chenyurong22/OpenDALI_EVG/Hardware/README.md

# Hardware

PCB designs for the OpenDALI_EVG project.

> Trademark notice — see [root README](../README.md): *DALI*, *DALI-2* etc. are DiiA trademarks; this project is an independent IEC 62386 implementation, not DiiA-certified.

## Manufacturing

The Gerber files are ready for upload to any PCB manufacturer. The JLCPCB files (BOM + CPL) allow direct ordering with SMT assembly through [JLCPCB](https://jlcpcb.com/).
