chenyurong22/OpenDALI_EVG/Hardware/DALI_Load_250W_RGBW/Readme.md

# LoadBoard 250W RGBW

LED driver and AC power switching board. Connects to the Controller via a 10-pin FFC cable (0.5 mm pitch) and provides:
- Mains switching for controlling the LED AC/DC Powersupply
- Power limits for the connected PSU: **max 1.2 A continuous** (without airflow), **max 3 A continuous** (with active airflow over the triac)
- 4-Channel PWM LED Driver (RGBW)

> **⚠ Work in progress.** This board is still under development.
> **⚠ Current Consumption** on the DALI Bus is to high while transfering from "off" to "on" state (4.1mA). This technically violates the specification.
