chenyurong22/OpenDALI_EVG/Hardware/DALI_Load_250W_RGBW/BOM-DALI_Load_250W_RGBW(V0.2).pdf

Comment | Description | Designator | Footprint | Quantity
MOC3043 | Zero-Cross Triac Driver Output Optocoupler | A1 | DIP762W46P254L889H5 08Q6B | 1
1uF | Capacitor | C1, C2, C3, C8 | C0402 | 4
100nF | Capacitor | C4, C5, C11 | C0402 | 3
10uF/50V | Capacitor | C12, C19 | C1206 | 2
100nF/50V | Capacitor | C16 | C0402 | 1
22uF | Capacitor | C17, C18 | C0603 | 2
ACST410-8BTR | TRIAC Alternistor -Snubberless, 600V, 4A DPAK | D1 | TO229P994X240-3N (DPAK) | 1
1N4148W | Diode | D2 | SOD-123 | 1
1.5A | Fuse | F1 | 1808 Fuse / FUSE_0154004 | 1
GZ1608D601TF | Ferrite_Bead | FB1 | 0603 | 1
LGS5145 | 60-V, 600-mA High Efficiency Wide Input Voltage Range Buck Converter | IC1 | SOT95P280X110-6N (SOT23-6L) | 1
FFC 0.5mm 10Pin 90° | FFC 0.5mm 10P Bottom Connection C262659 | J1 | TE_1-1734592-0 | 1
NLCV32T-100K-PF (10uH) | 15uH | L1 | L1210 | 1
KF142R-5.08-4P | KF142R-5.08-4P | P1 | CONN-TH_4P-P5.08_KF142R-5.08-4P | 1
KF2EDGR-3.81-5Pin | KF2EDGR-3.81-5Pin | P2 | CONN-TH_5P-P3.81_KF2EDGR-3.81-5P | 1
4 Pin male | 4 Pin male | P7 | TE_826647-4 | 1
AO3400A | 30V N-Channel MOSFET | Q1 | SOT23 Normal | 1
IRLU024N | N-HEXFET Power MOSFET | Q3, Q4, Q5, Q6 | TO228P680X240X837-3 (TO-251) | 4
10 | Resistor | R1, R2, R3, R7, R8, R9, R10, R17 | 0402 | 8
390 | Resistor | R4, R16 | R0603 | 2
100k | Resistor | R12, R13, R14, R15, R19 | 0402 | 5
1k | Resistor | R18 | 0402 | 1
15k | Resistor | R20 | 0402 | 1
75k | Resistor | R46 | R0603 | 1
12k | Resistor | R47 | 0402 | 1
UCC27517DBVR | 4-A/4-A single-channel gate driver with 5-V UVLO and 13-ns prop delay in SOT-23 package | U1, U2, U3, U4 | SOT23-5 | 4
pi160M30 | π160M30 | U5 | SOIC127P600X180-16N SOP-16 | 1
