chenyurong22/OpenDALI_EVG/Hardware/Controller/JLC_PCBA_BOM-DALI_EVG_Controller(V0.3).xlsx

Comment | Description | Designator | Footprint | Quantity | JLCPCB Part #
100nF | Capacitor | C1, C3, C4, C11, C13, C14, C15 | C0402 | 7 | C307331
1nF | Capacitor | C6 | C0603 | 1 | C1588
10uF/50V | Capacitor | C12, C19 | C1206 | 2 | C13585
100nF/50V | Capacitor | C16 | C0402 | 1 | C307331
22uF | Capacitor | C17, C18 | C0603 | 2 | C59461
1uF | Capacitor | C21 | C0603 | 1 | C15849
220uF/35V | Polarized Capacitor (Axial) | C24 | CAPR-5mm | 1 | C1590097
1N4148W | Diode | D1, D4 | SOD-123 | 2 | C81598
MB10S |  | D3 | SOIC245P670X290-4N | 1 | C2488
500mA | Fuse | F1, F2 | 1206 | 2 | C99561
GZ1608D601TF | Ferrite_Bead | FB1, FB2, FB3 | 0603 | 3 | C1002
LGS5145 | 60-V, 600-mA High Efficiency Wide Input Voltage Range Buck Converter | IC1 | SOT95P280X110-6N (SOT23-6L) | 1 | C5123971
C720477 | Tactile Switch | J2, J3 | TS-1088-AR02016 | 2 | C720477
FFC 0.5mm 10Pin 90° | FFC 0.5mm 10P Bottom Connection C262659 | J4 | TE_1-1734592-0 | 1 | C262659
Terminalblock X2 |  | J6, J7 | Terminalblock_X2_5mm | 2 | C474881
CMI321609X100KT (10uH) | 15uH | L1 | L1210 | 1 | C1051
KF2EDGR-3.5-2Pin | KF2EDGR-3.5-2Pin | P6 | CONN-TH_2P-P3.50_KF2EDGR-3.5 | 1 | C441171
Header | 4 Pin male | P7 | TE_826647-4 | 1
AO3400A | 30V N-Channel MOSFET | Q1 | SOT23 Normal | 1 | C20917
1 | Resistor | R2 | R0805 | 1 | C25271
1k | Resistor | R3, R29 | 0402 | 2 | C11702
100k | Resistor | R4 | 0402 | 1 | C25741
10k | Resistor | R8, R9, R18, R23, R47 | 0402 | 5 | C25744
15k | Resistor | R12 | 0402 | 1 | C25756
10 | Resistor | R27 | R0603 | 1 | C22859
470k | Resistor | R28 | R0603 | 1 | C23178
4.7k | Resistor | R30 | R0603 | 1 | C23162
100k | Resistor | R31 | R0603 | 1 | C25803
8.2k | Resistor | R32 | R0603 | 1 | C25981
18k | Resistor | R33 | R0603 | 1 | C25810
33k | Resistor | R46 | R0603 | 1 | C4216
CH32V003F4U6 | CPU Core:RISC-V CPU Maximum Speed:48MHz Program Storage Size:16KB Number of I/O:18 Applications:- | U1 | QFN-20_L3.0-W3.0-P0.40-TL-EP1.7 | 1 | C5299908
LMV331IDBVRG4 | Single General Purpose Low-Voltage Comparator 5-SOT-23 | U2 | SOT23-5 | 1 | C34731
AT24C256C-SSHL-T | AT24C256C-SSHL-T | U3 | SOIC127P600X265-8N (SOIC-8) | 1 | C6482
