chenyurong22/OpenDALI_EVG/Hardware/Controller/DALI_EVG_Controller_V0.3-Schematic.PDF

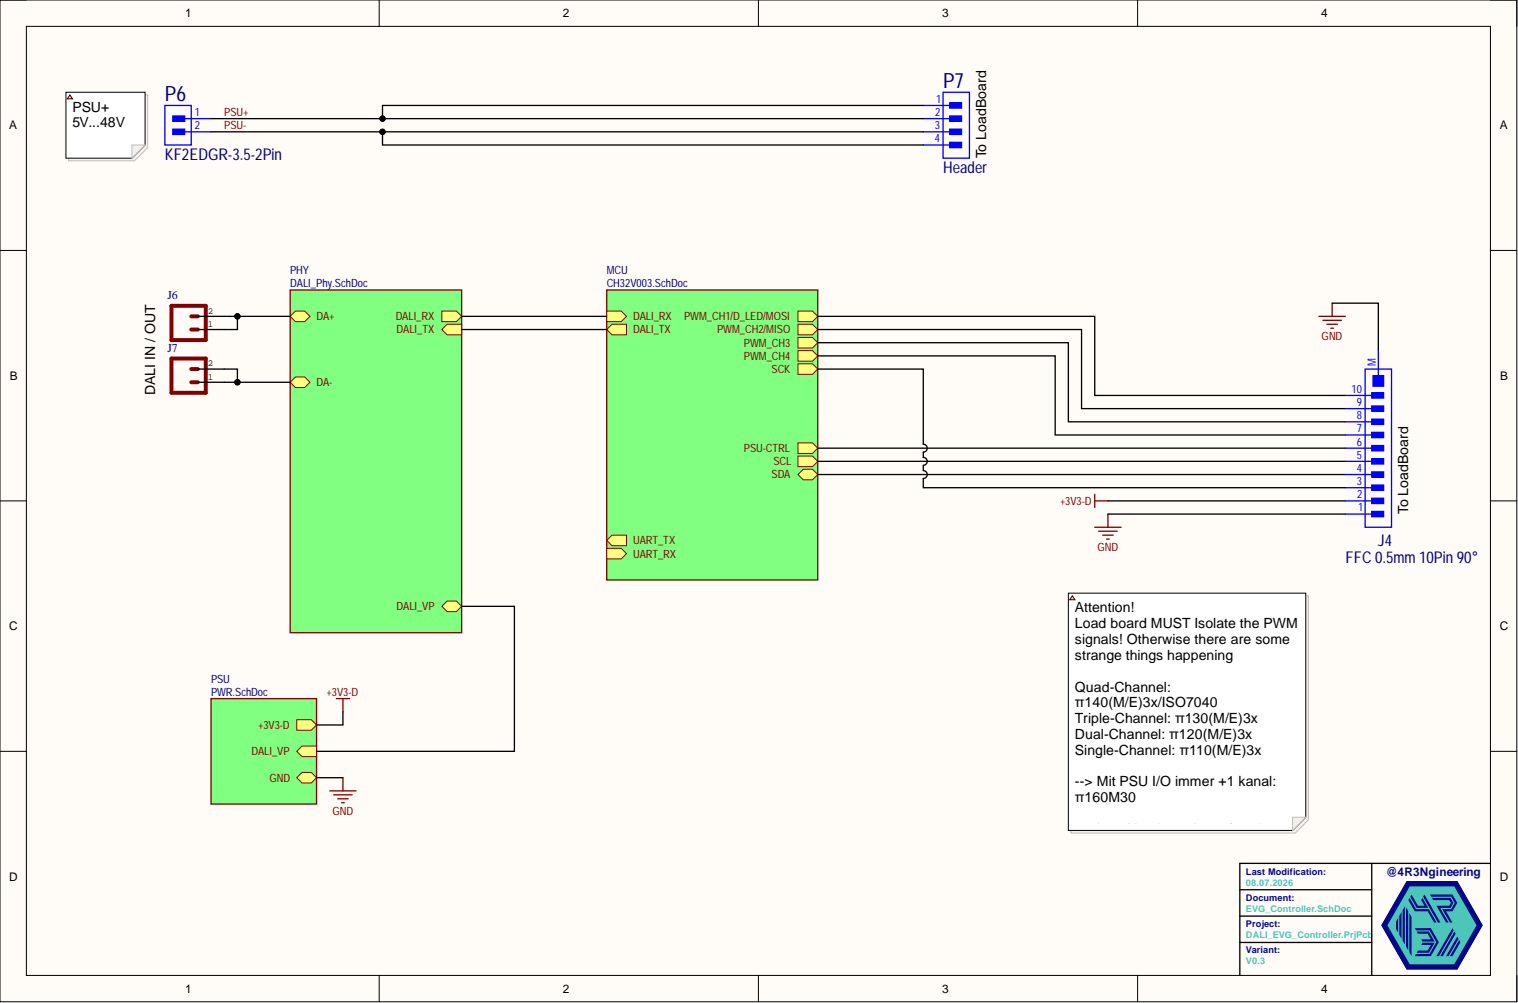
[picture p2: page 1]

Attention!
Load board MUS
signals! Otherwise there are some
strange things happening

Quad-Channel: π140(M/E)3x/ISO7040 Triple-Channel: π130(M/E

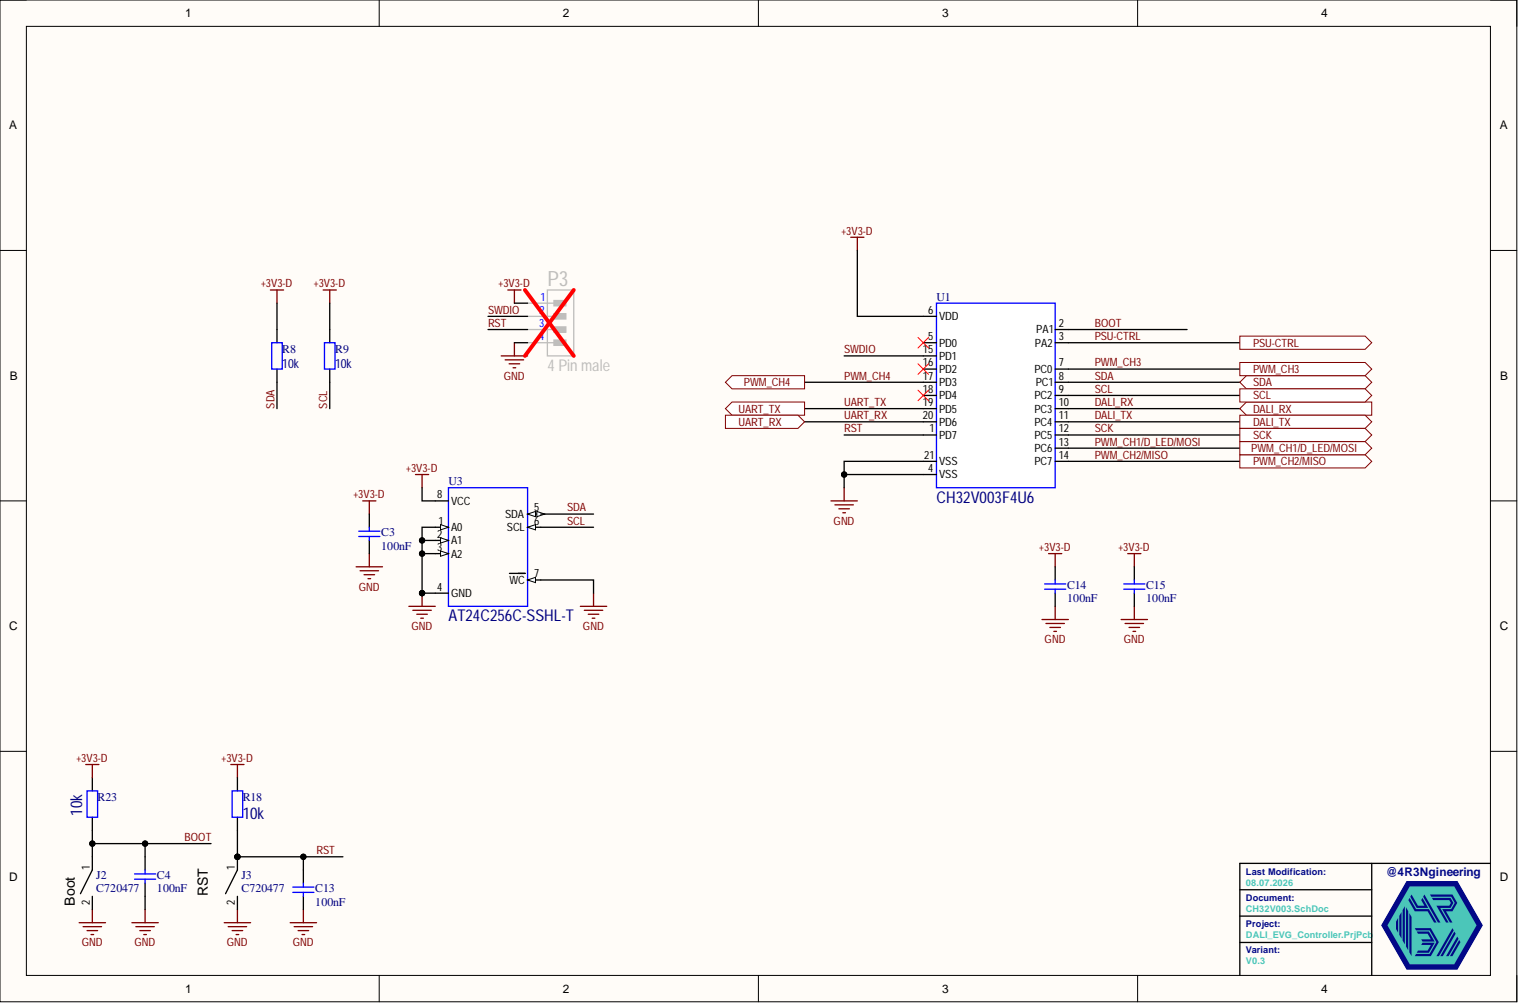
[picture p3: page 2]

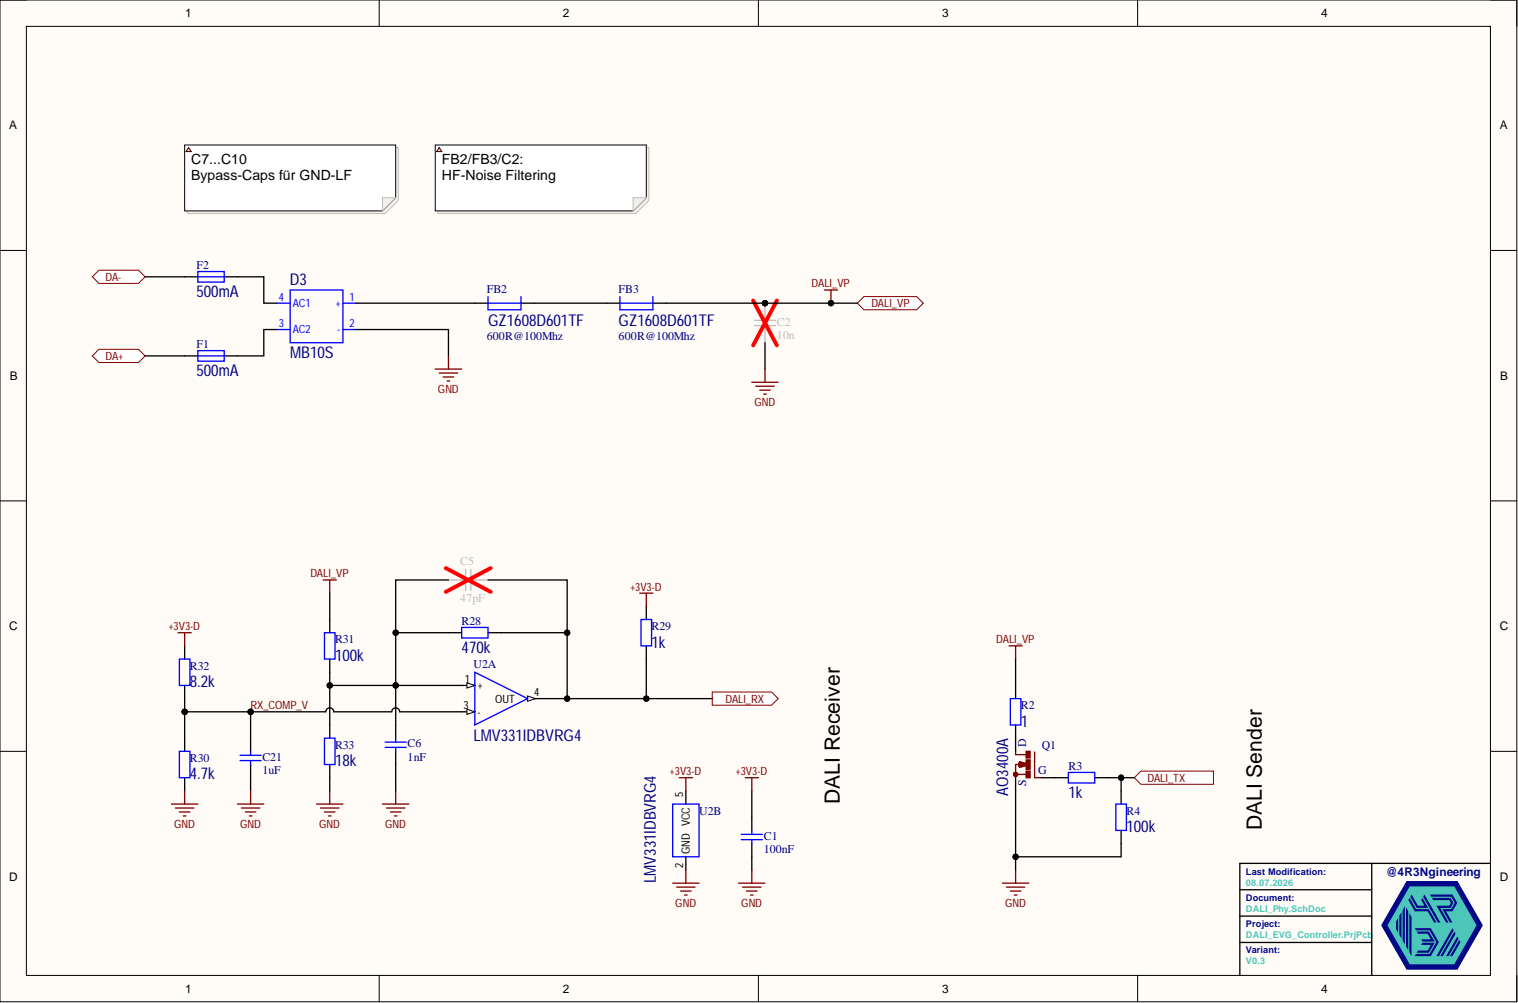
[picture p4: page 3]

Bypass-Caps für GND-LF

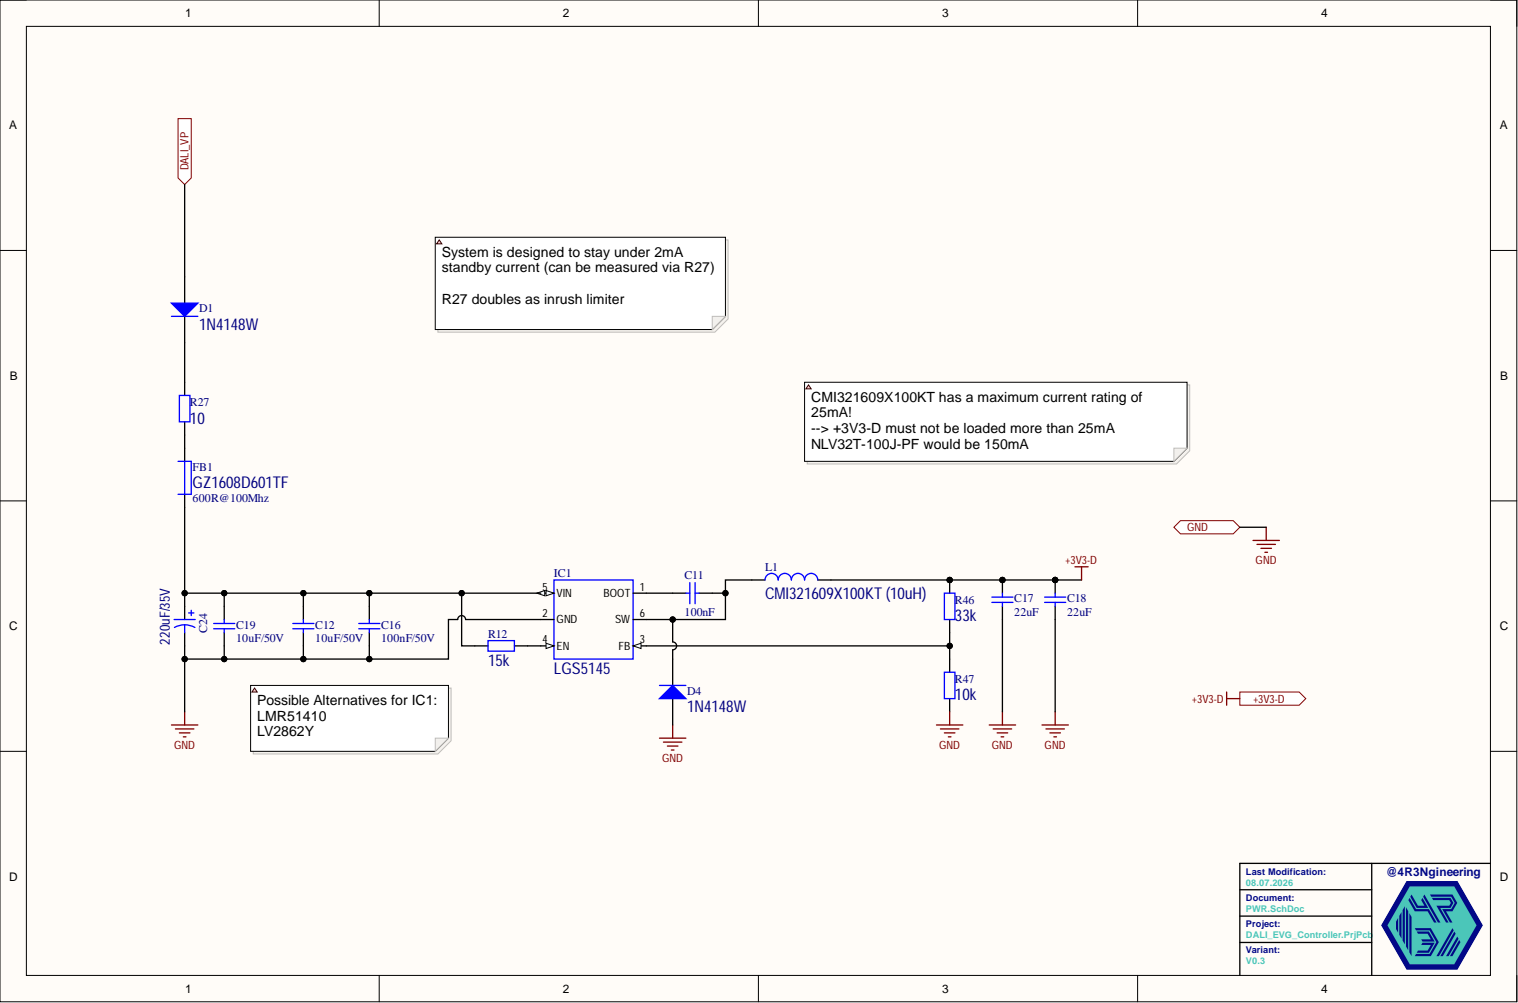
[picture p5: page 4]

System is designed to stay under 2m
standby cur

rent (can be measured via R27)

R27 doubles as inrush limiter

-> +3V3-D must not be loaded more than 25m
