chenyurong22/OpenDALI_EVG/Hardware/Controller/DALI_EVG_Controller_V0.3-Pinout.PDF

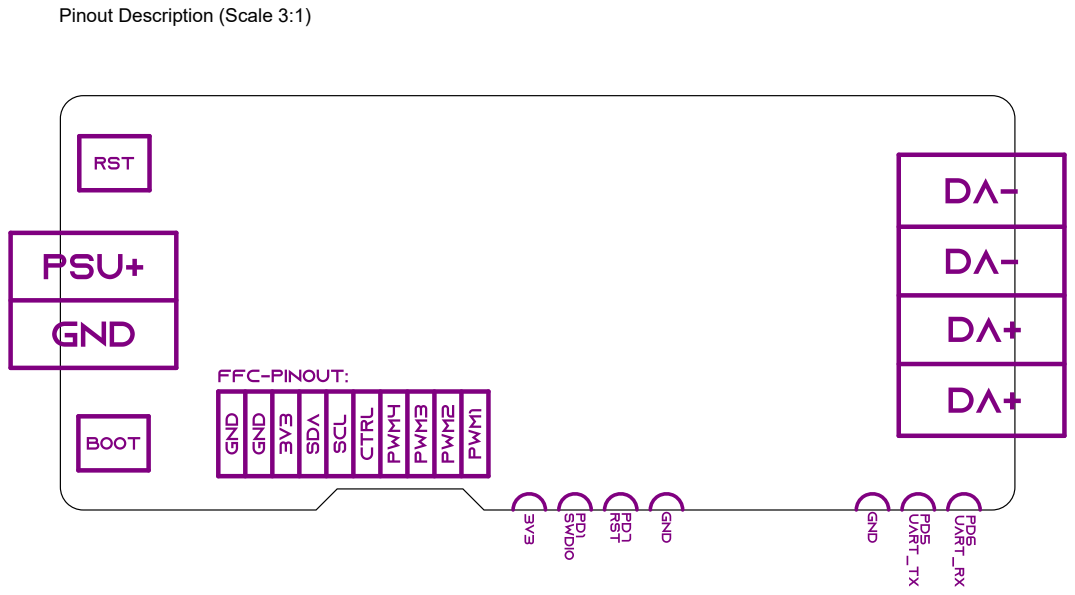
[picture p6: page 1]

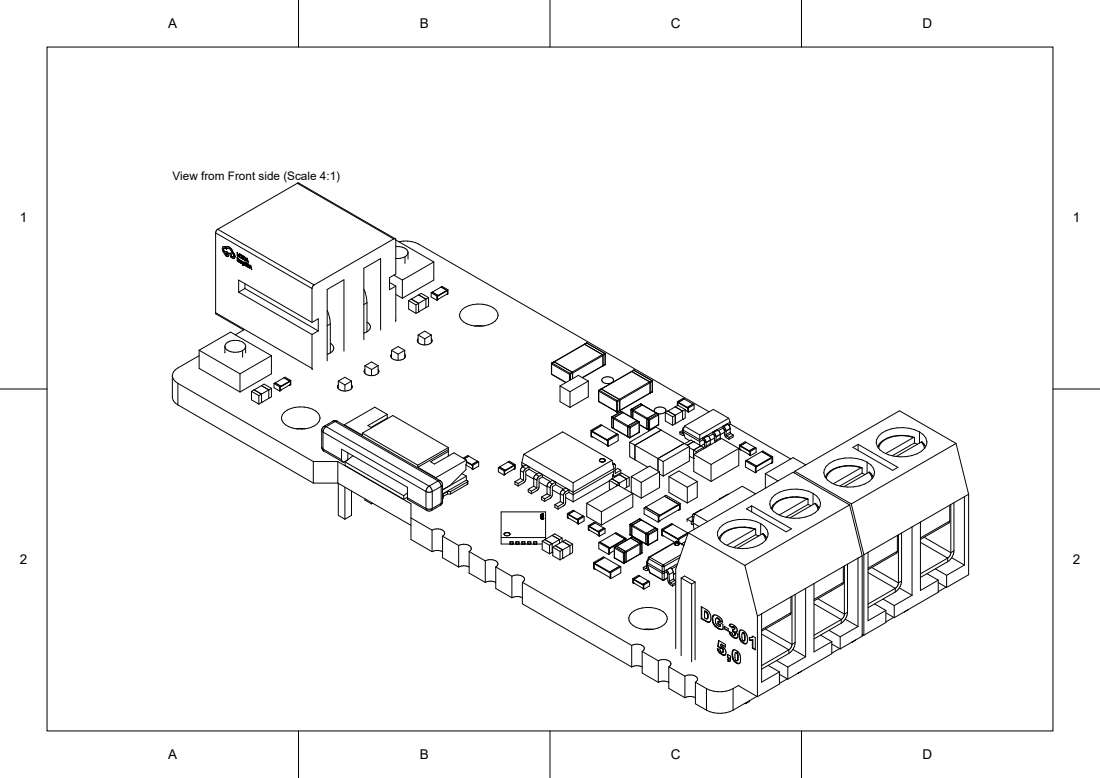
[picture p7: page 2]

View from Front side (Scale 4:1)
