chenyurong22/OpenDALI_EVG/Hardware/Controller/DALI_EVG_Controller_V0.3_Assembly.PDF

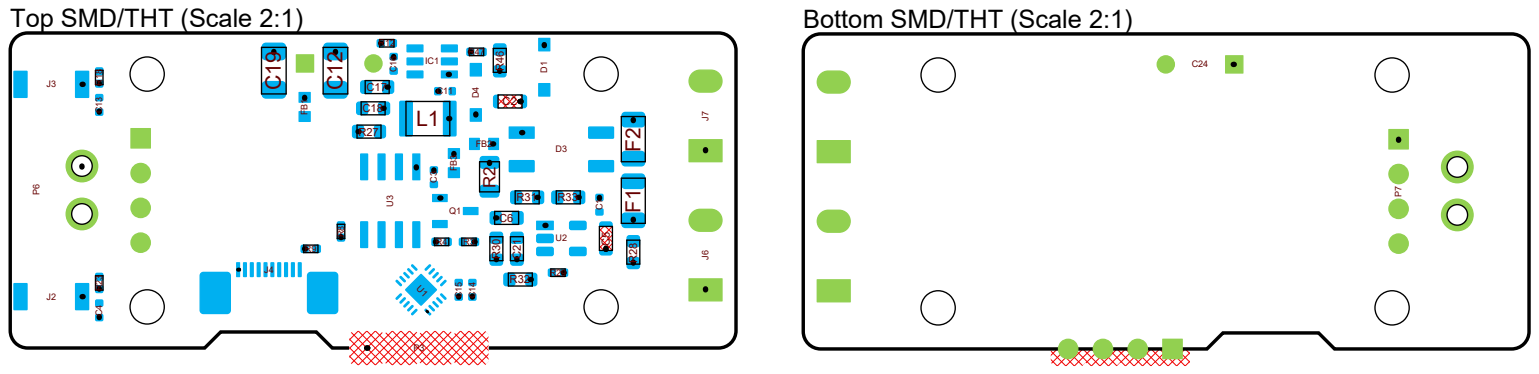
[picture p8: page 1]

Top SMD/THT (Scale 2:1)

Bottom SMD/THT (Scale 2:1)

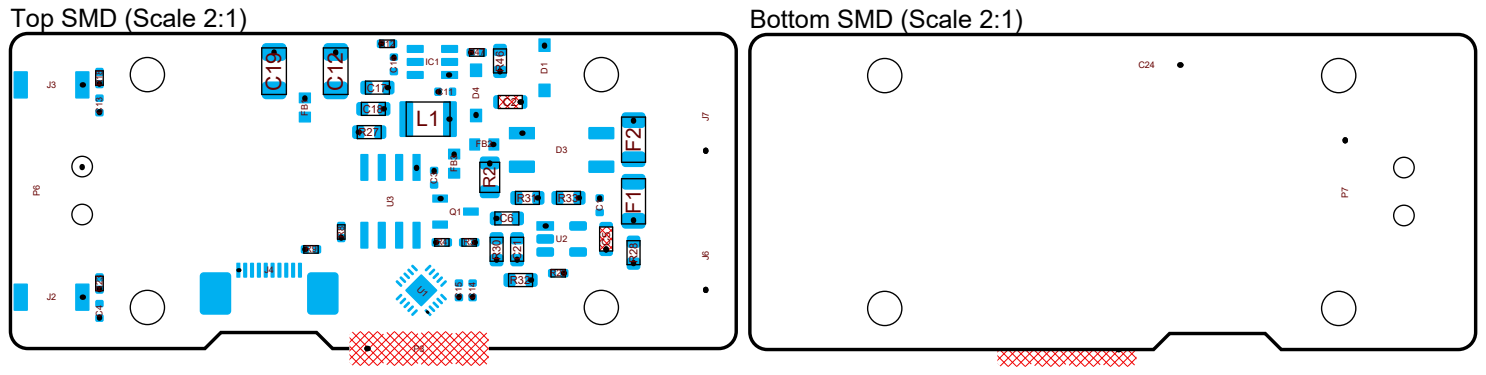
[picture p9: page 2]

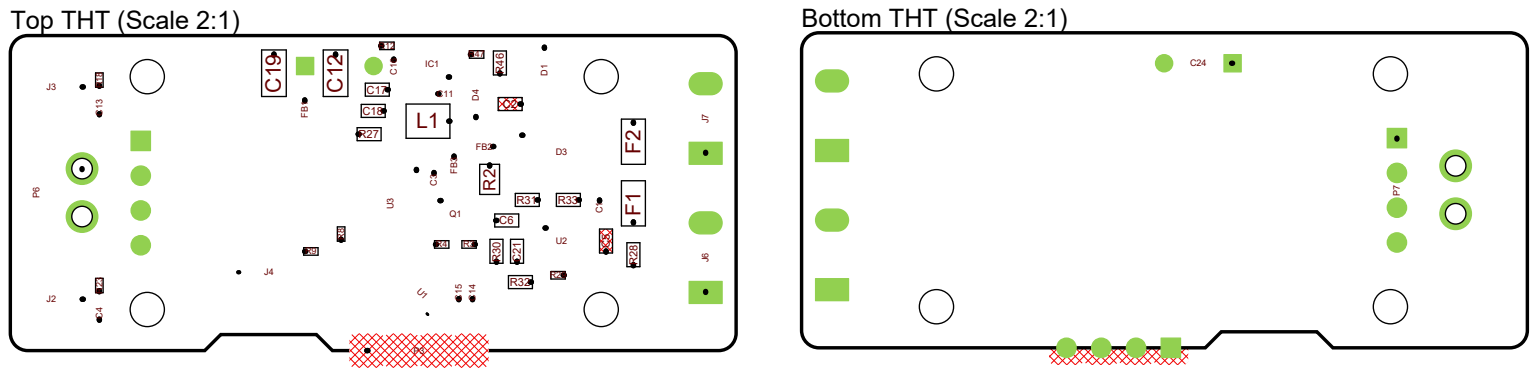
[picture p10: page 3]

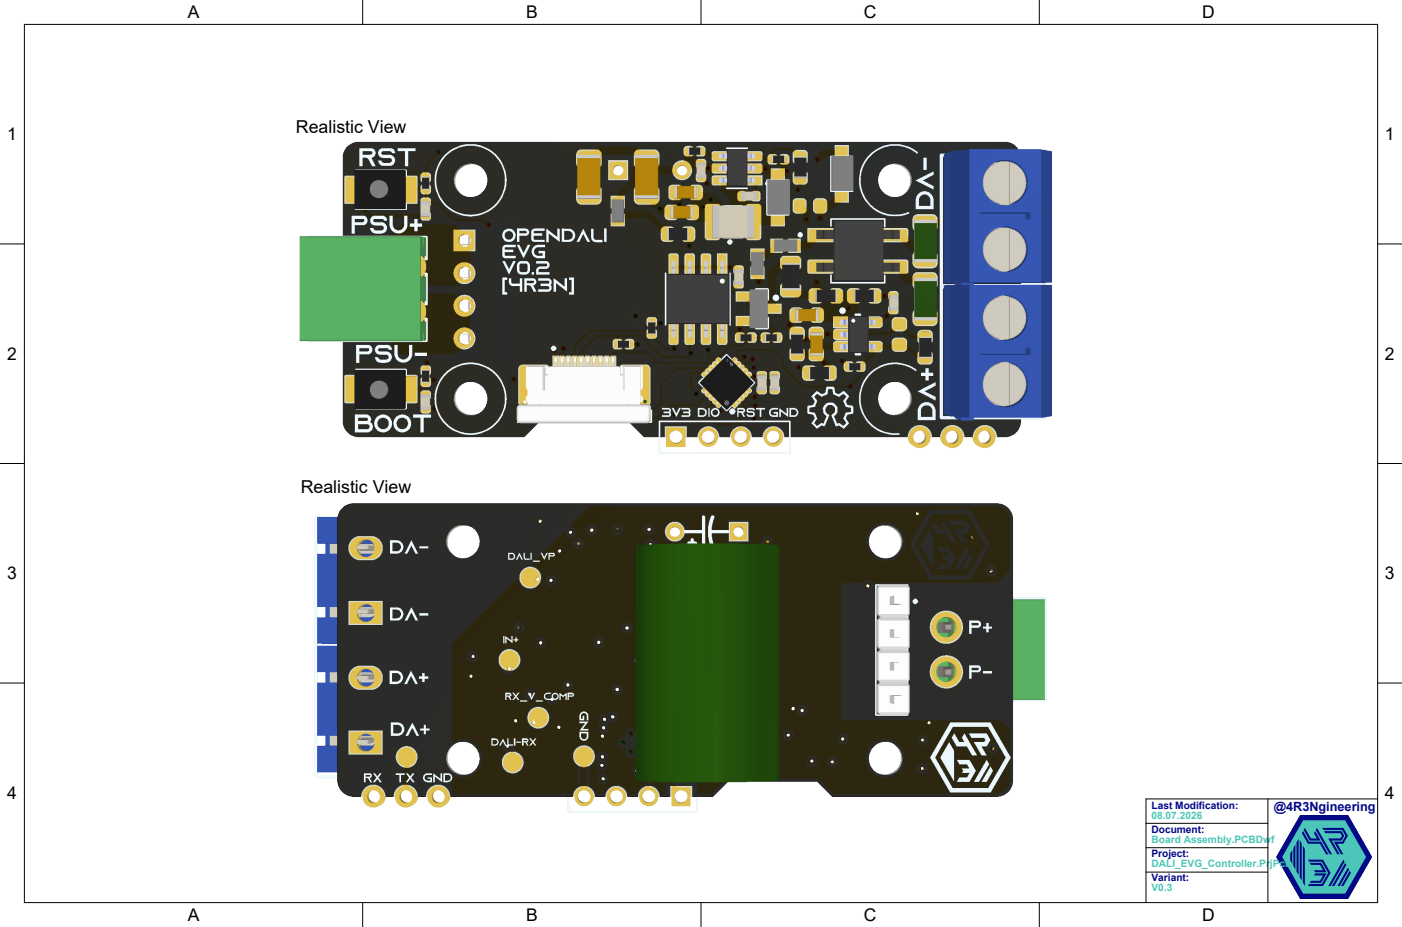
[picture p11: page 4]
