chenyurong22/OpenDALI_EVG/Hardware/DALI_Load_250W_RGBW/DALI_Load_250W_RGBW_V0.2_Assembly.PDF

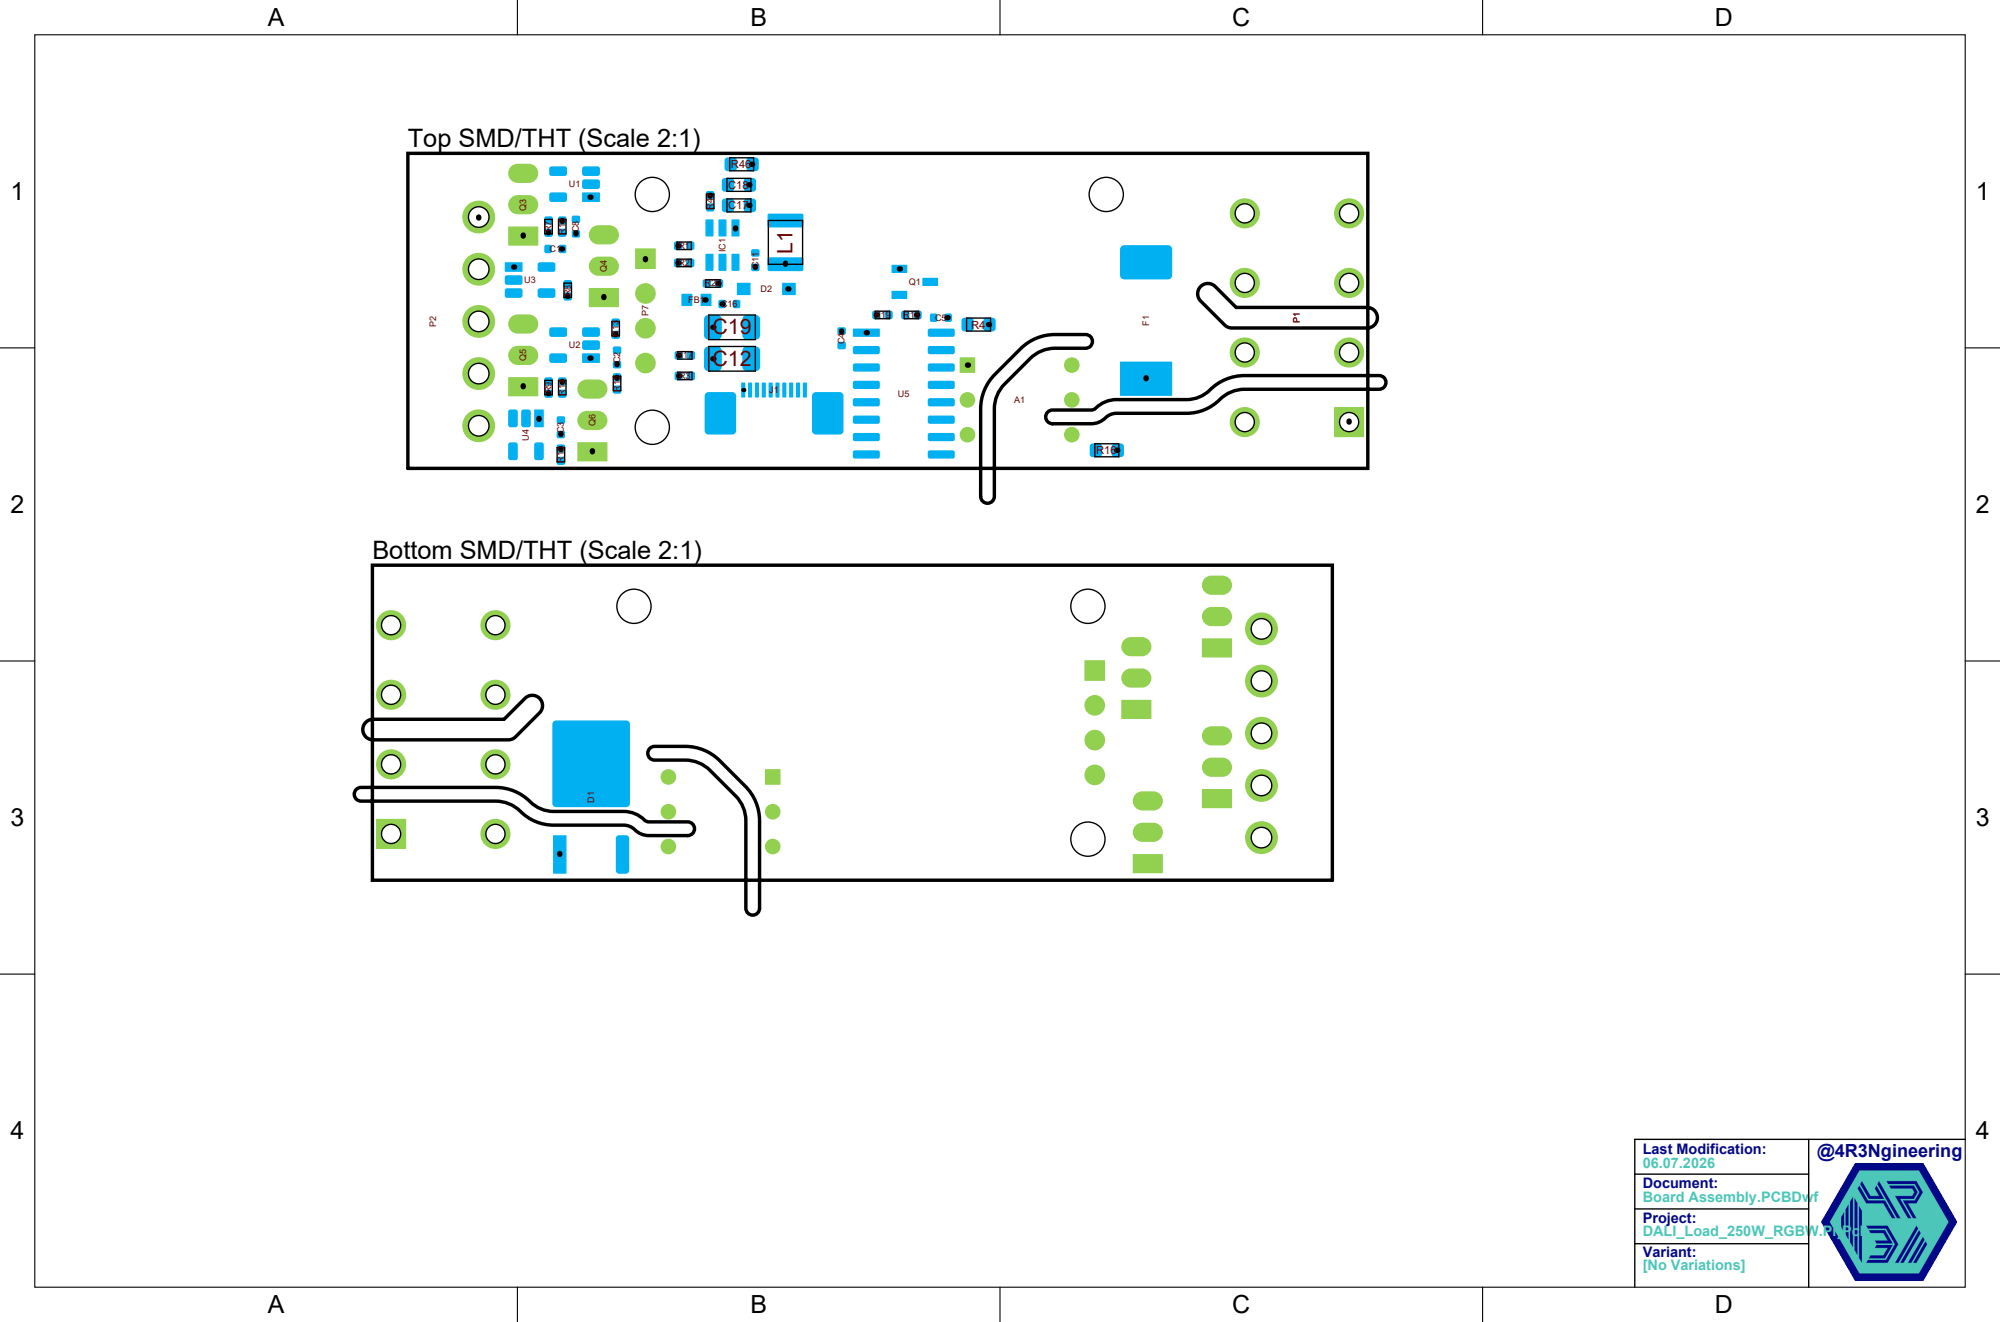
[picture p12: page 1]

Top SMD/THT (Scale 2:1) D1

Bottom SMD/THT (Scale 2:1)

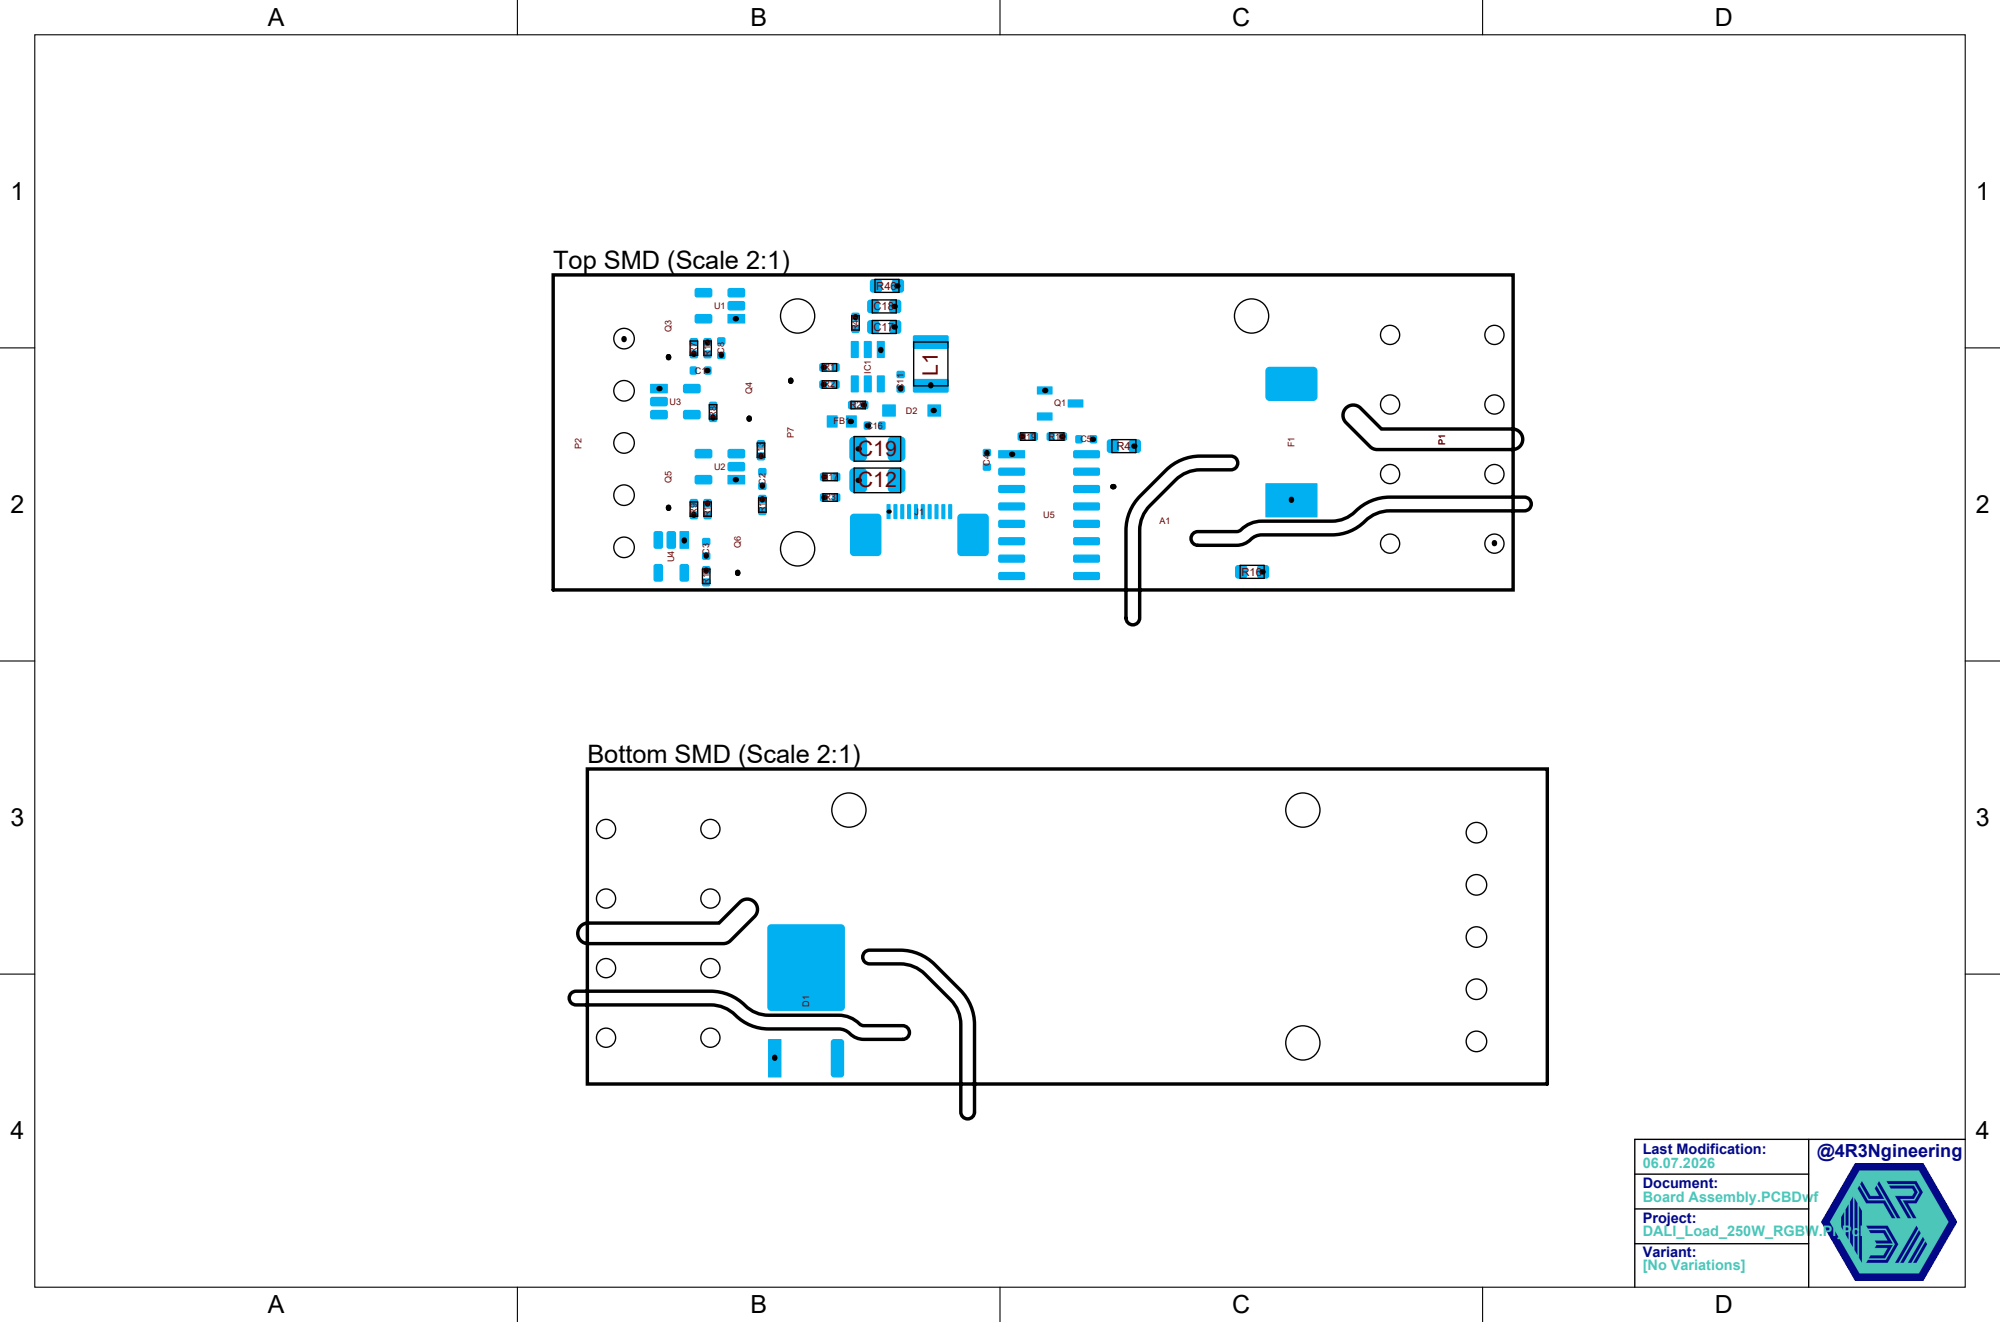
[picture p13: page 2]

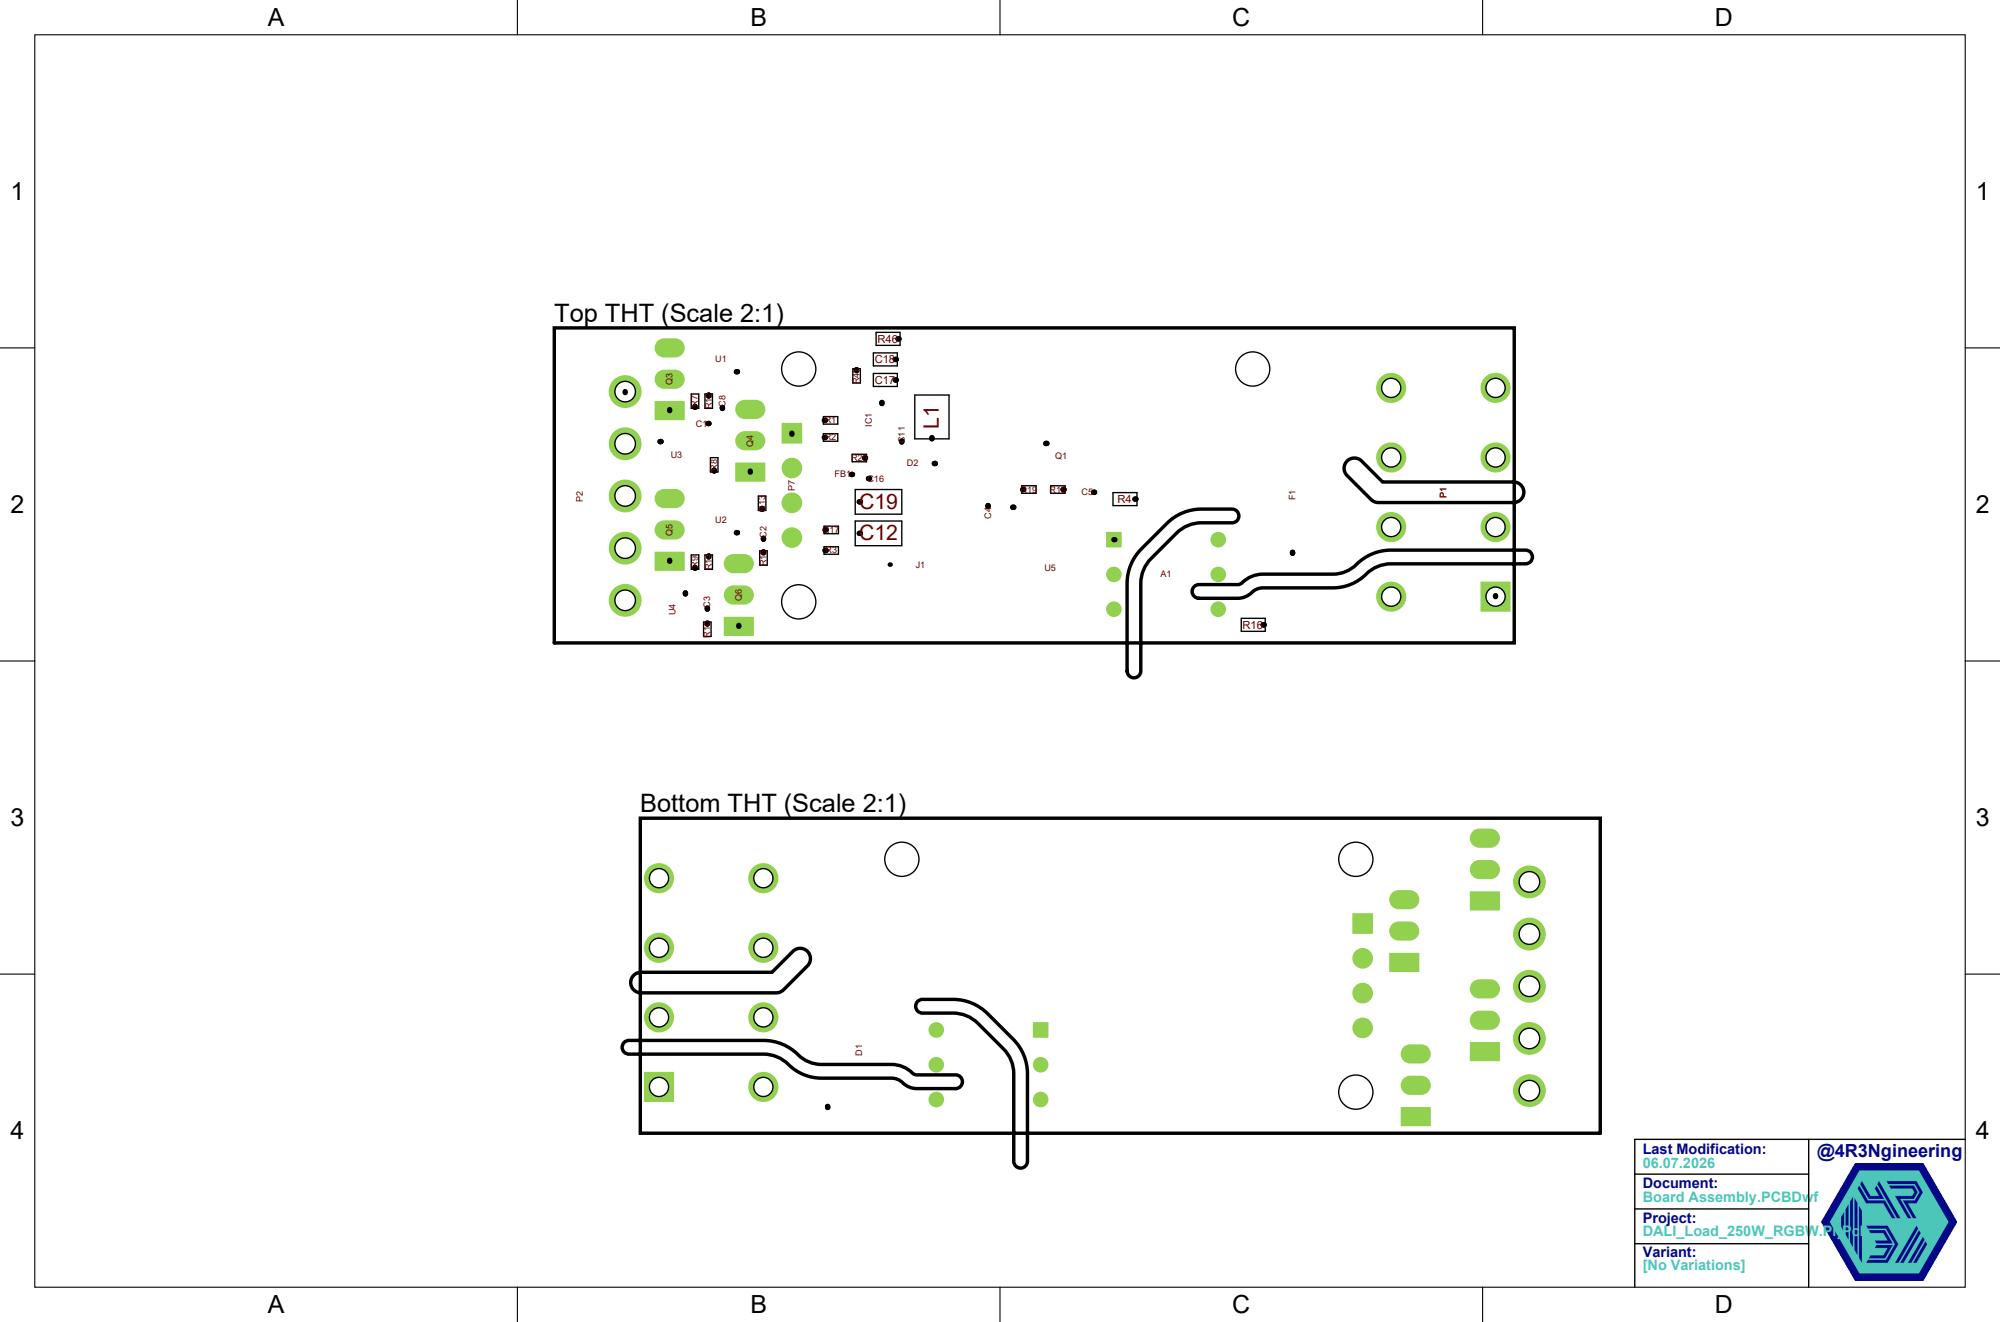
[picture p14: page 3]

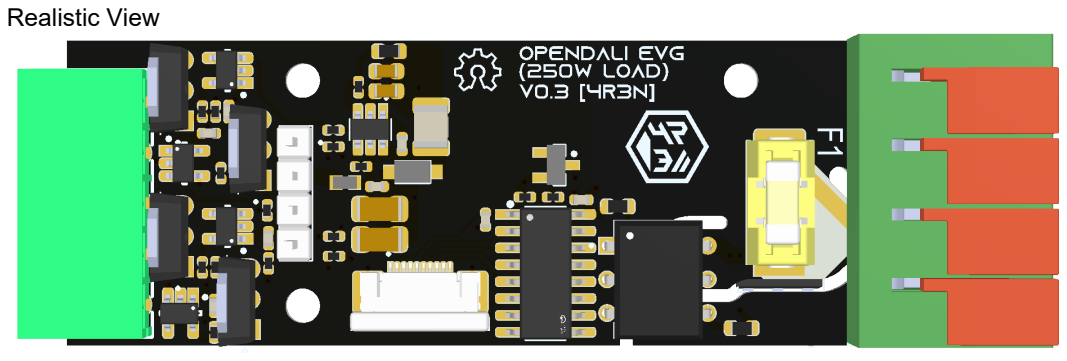
[picture p15: page 4]
