chenyurong22/OpenDALI_EVG/Hardware/DALI_Load_250W_RGBW/DALI_Load_250W_RGBW_V0.2-Schematic.PDF

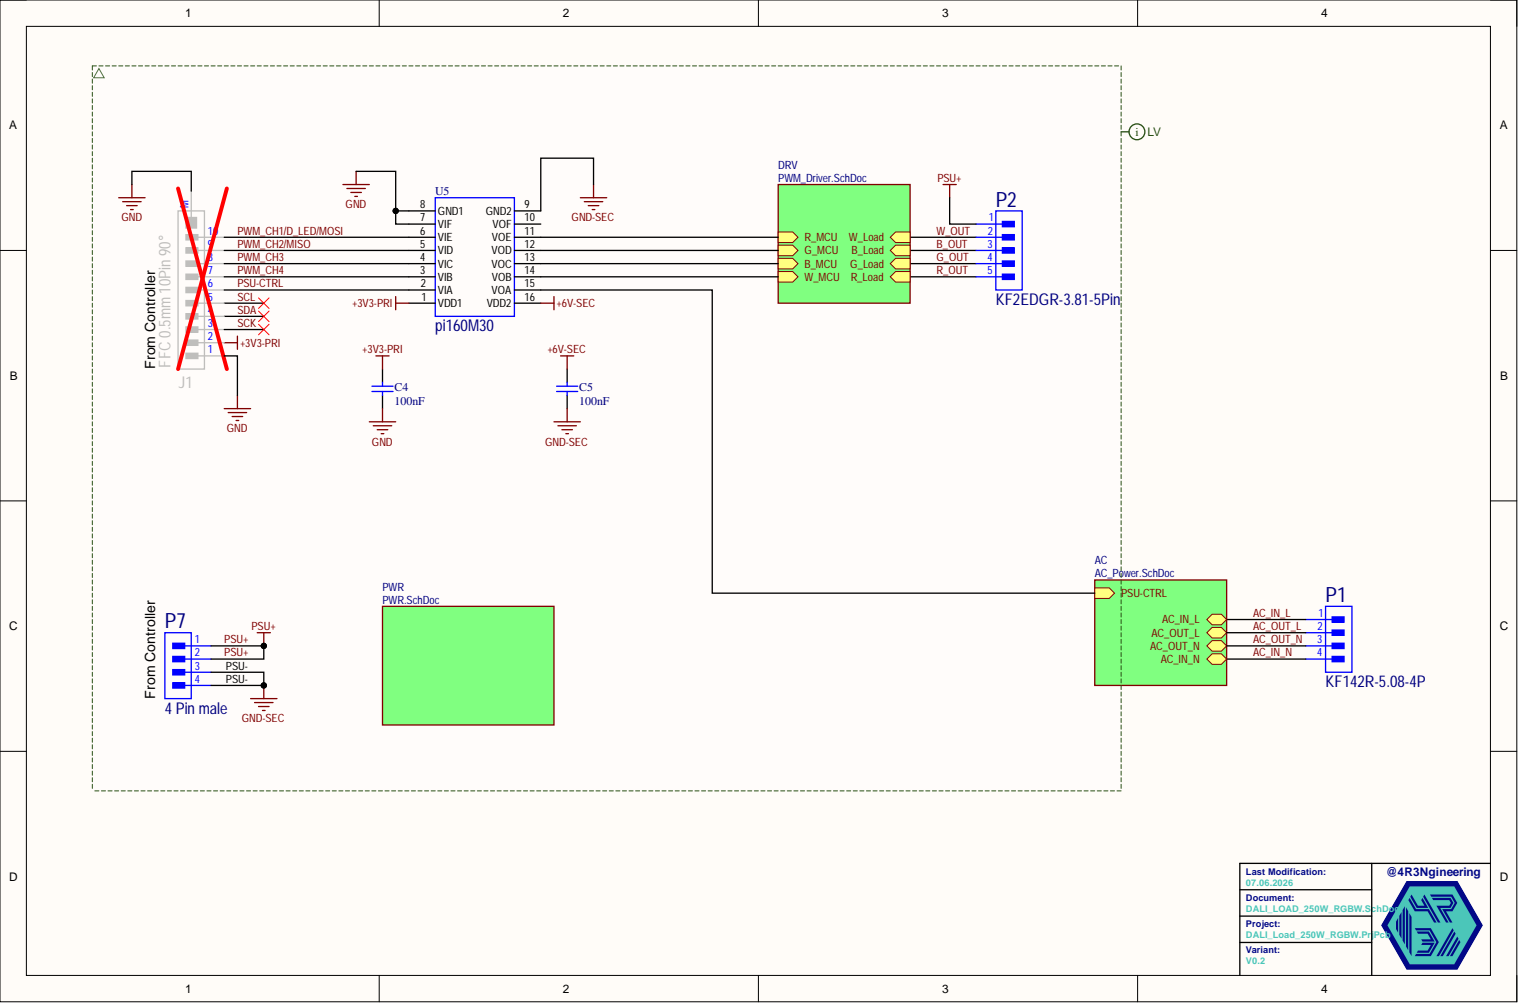
[picture p16: page 1]

From Controller

PSU-CTR L AC_IN_L AC_O UT_L AC_O UT_N AC_IN_N

PSU -

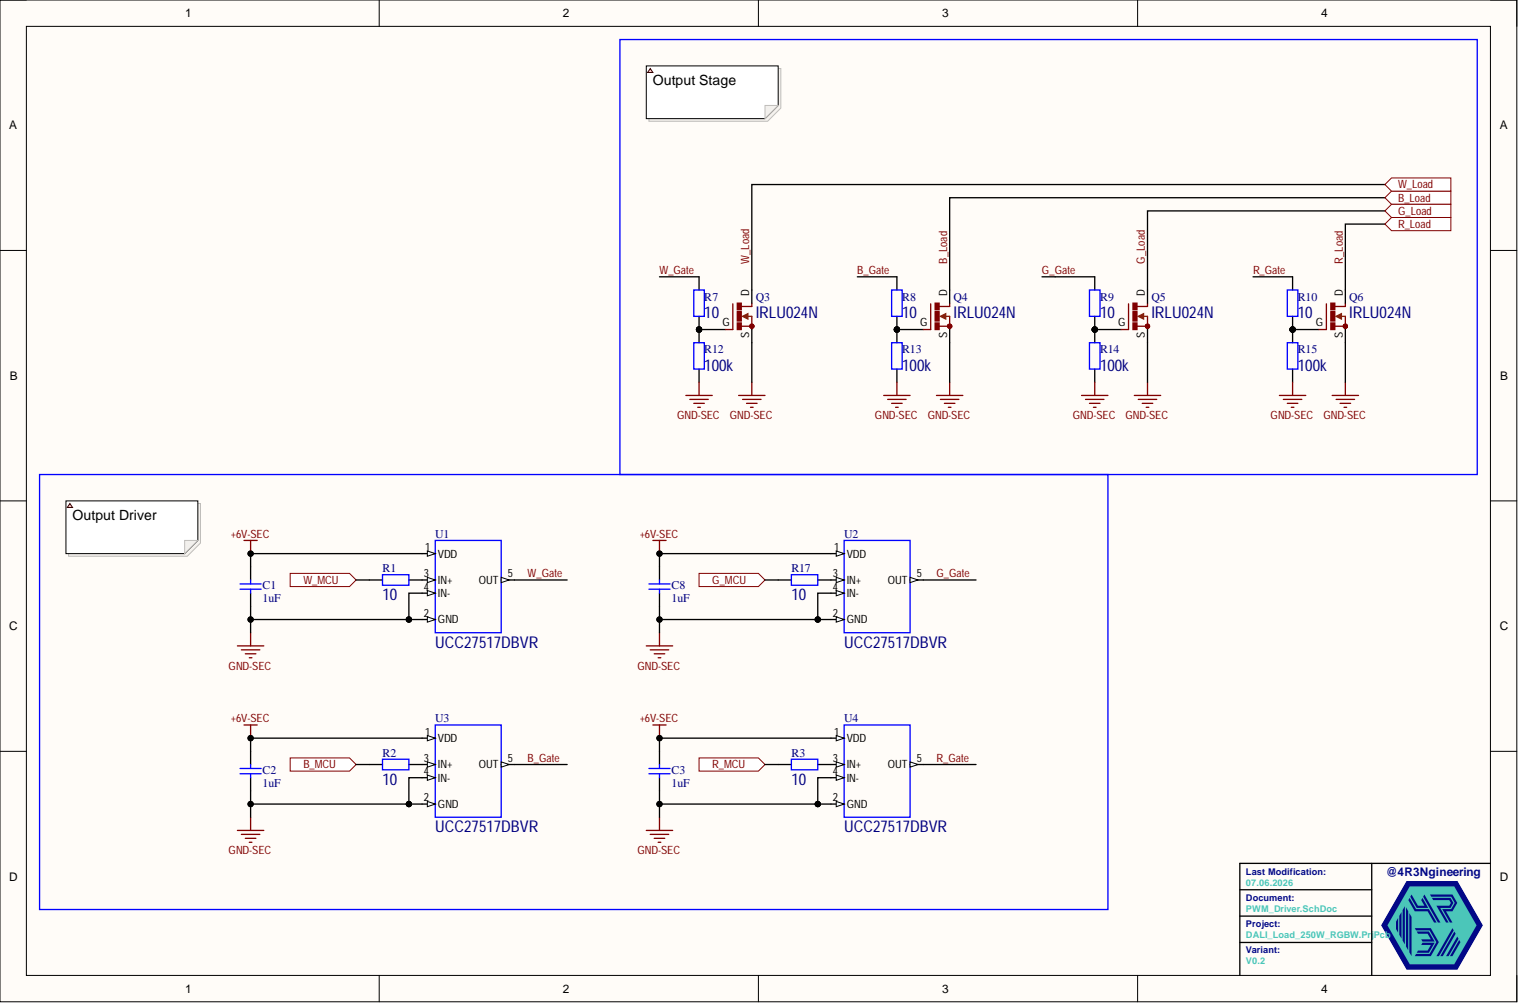
[picture p17: page 2]

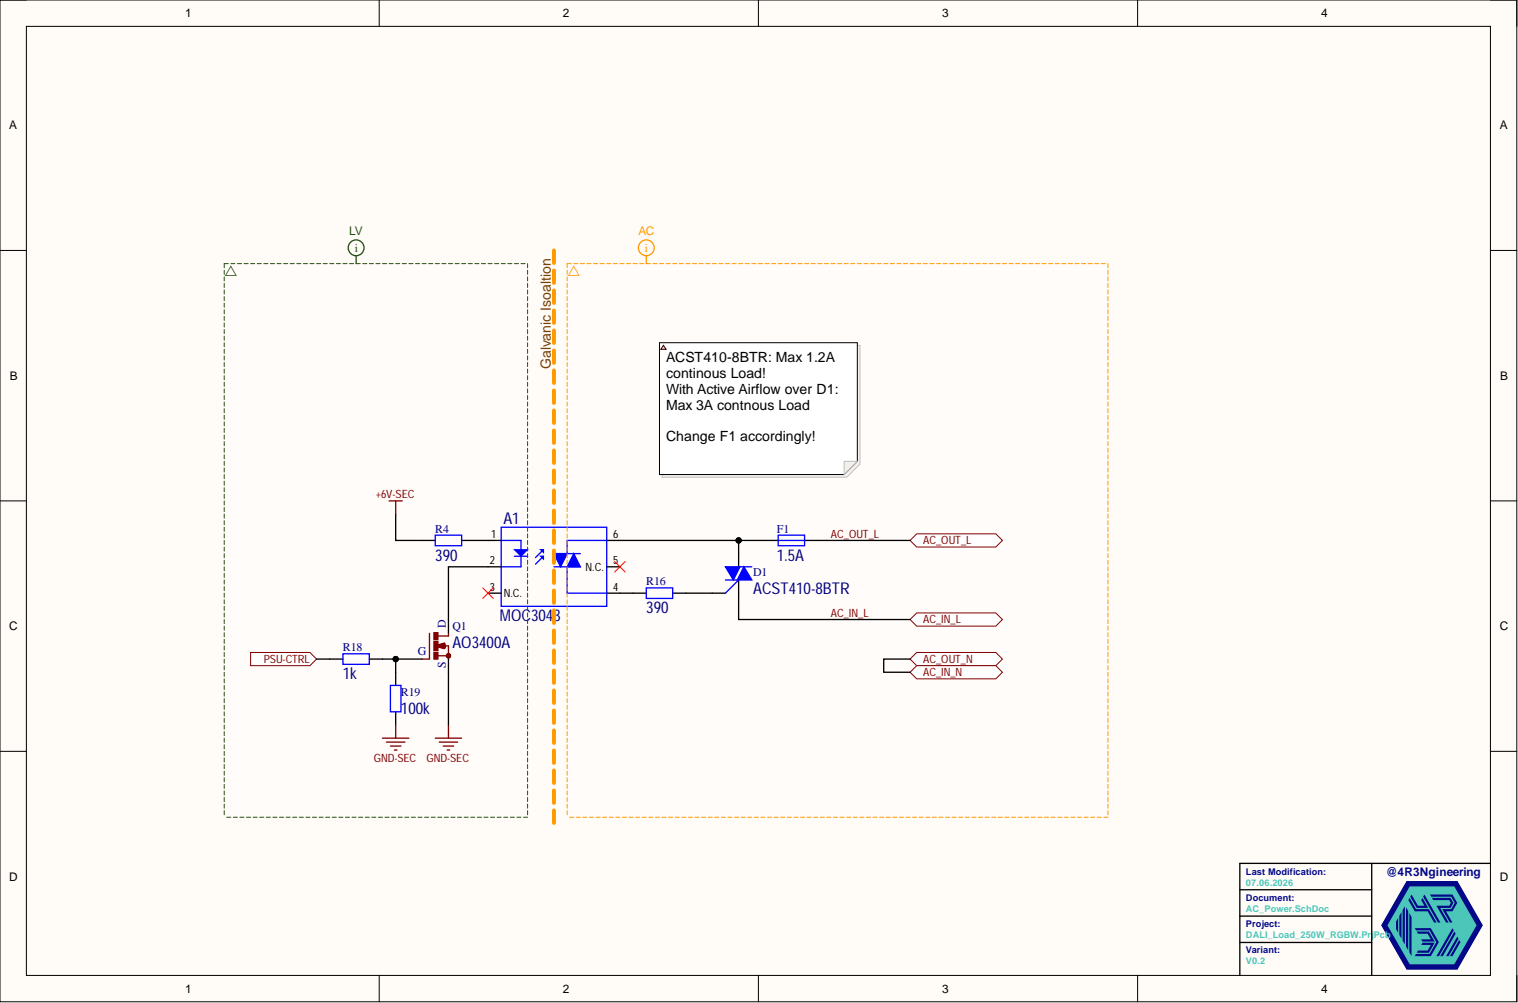
[picture p18: page 3]

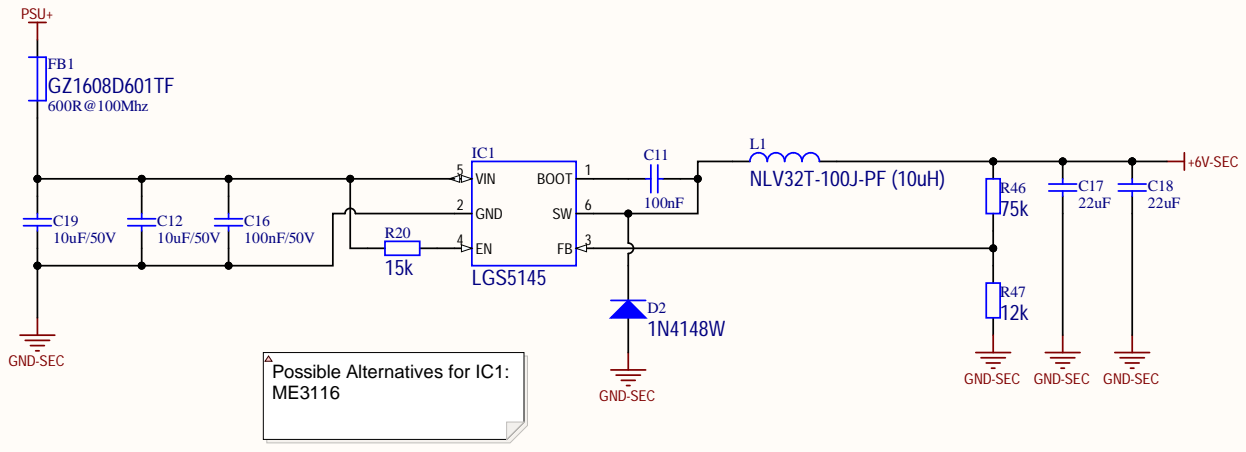
[picture p19: page 4]
