chenyurong22/OpenDALI_EVG/Simulations/Sec_Linear_Regulator.asc

C1: cap; 10µ
D1: zener; MMBZ6V8ALY
D2: zener; MMBZ6V8ALY
I1: current; PULSE(0 5m 0 1f 1f 25u 50u)
I2: current; PULSE(0 1.2m 0 1f 1f 25u 50u)
Q1: npn; 2N5550
R1: res; 10k
R2: res; 100k
R3: res; 14k
V1: voltage; 48
Named nets: 0
.tran 10m
