chenyurong22/OpenDALI_EVG/Simulations/Floating_AC_Noise.asc

C1: cap; 5n
C2: cap; 220µ
C3: cap; 1n
C4: cap; 5n
D1: schottky; MBRS1100
D2: schottky; MBRS1100
D3: diode; 1N4148
D4: schottky; MBRS1100
D5: diode
I1: current; 1.7m
R1: res; 10
R3: res; 100k
R4: res; 18k
V1: voltage; SINE(0 300 50)
V2: voltage; PULSE(0.5 16 0 10u 10u 416u 833u)
V3: voltage; SINE(0 300 50 1m)
Named nets: To_Dekoder, 0
.tran 200m
