chenyurong22/OpenDALI_EVG/Simulations/BusVoltage_Cutoff_OPA.asc

D1: zener; UMZ18K
D2: diode
D3: diode
D4: diode
I1: current; 2m
M1: pmos; FDR840P
M2: nmos; 2N7002
Q1: pnp; 2N2907
R1: res; 100k
R2: res; 10k
R3: res; 100k
R4: res; 1k
R5: res; 10k
R6: res; 22k
R7: res; 10k
U1: LT1017
V1: voltage; 22.5
V2: voltage; PWL(0 24 10m 24 150m 0 200m 0)
V3: voltage; 3.3
Named nets: 0, 3.3V
Load
.tran 200m
Bus-Voltage
Secondary
Voltage
LMV321
