chenyurong22/OpenDALI_EVG/(commit log)

2026-05-02 Updated Bootloader, First Validation of Hardware
    [JLC_PCBA_BOM-DALI_EVG_Controller(V0.1).xlsx]
2026-05-04 First round of Debugging and Bugfixes
    [JLC_PCBA_BOM-DALI_EVG_Controller(V0.1).xlsx, JLC_PCBA_BOM-DALI_EVG_Controller(V0.2).xlsx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]
2026-05-04 Hotfix DCDC auto-Enable applied
    [JLC_PCBA_BOM-DALI_EVG_Controller(V0.2).xlsx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]
2026-05-04 Gerber Fix
    [JLC_PCBA_BOM-DALI_EVG_Controller(V0.2).xlsx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]
2026-05-16 Updated readmes, Firmware fixes, V2.0 Controller HArdware
    [JLC_PCBA_BOM-DALI_EVG_Controller(V0.2).xlsx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]
2026-05-17 fixed critical RX timing-Bug, updated readmes
    [dali_phy.c]
2026-06-07 Upgraded Hardware and Readmes.
    [JLC_PCBA_BOM-DALI_EVG_Controller(V0.2).xlsx, JLC_PCBA_BOM-DALI_EVG_LoadBoard(V0.1).xlsx, JLC_PCBA_BOM-DALI_Load_250W_RGBW(V0.2).xlsx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]
2026-07-07 Updated Controller
    [JLC_PCBA_BOM-DALI_EVG_Controller(V0.2).xlsx, JLC_PCBA_BOM-DALI_EVG_Controller(V0.3).xlsx, JLC_PCBA_BOM-DALI_Load_250W_RGBW(V0.2).xlsx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]
2026-07-07 Bugfix C24
    [JLC_PCBA_BOM-DALI_EVG_Controller(V0.3).xlsx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]
